marwask/bike-power-meter/images/16.jpg

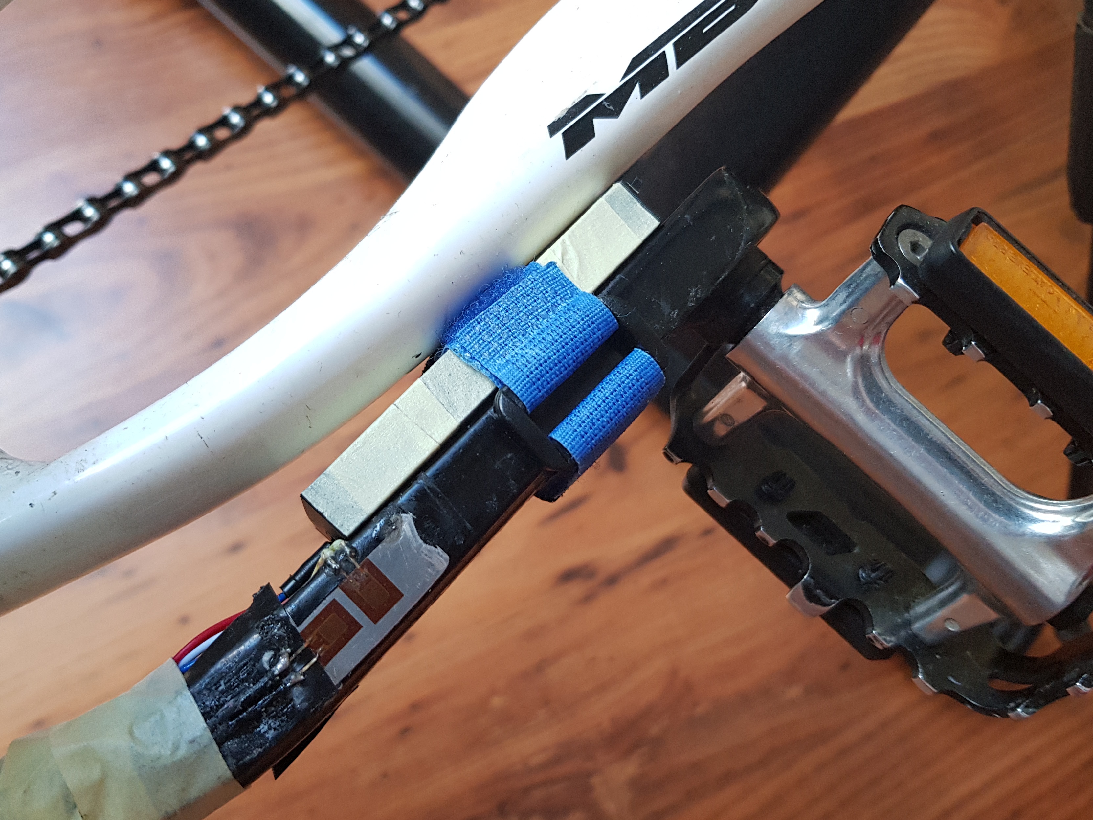
images/16.jpg
