marwask/bike-power-meter/src/config.h

#ifndef _CONFIG_H_
#define _CONFIG_H_

/////////////////////////////////////////////////

const bool initialConfiguration = false;
const float knownWeight = 5.1; // kg

/////////////////////////////////////////////////

const bool debug = false;
const int debugUpdateInterval = 1000;
const int bluetoothDebugUpdateInterval = 1000;

const int bluetoothBatteryUpdateInterval = 10000;

const float crankLength = 0.175; // 17.5cm
const int scaleValueToKgEquivalent = 9750;
const bool doublePower = false; // for valid TheSufferfest power values

#endif
